p0lysim/FFB-base-differential/docs/images/drivetrain.jpg

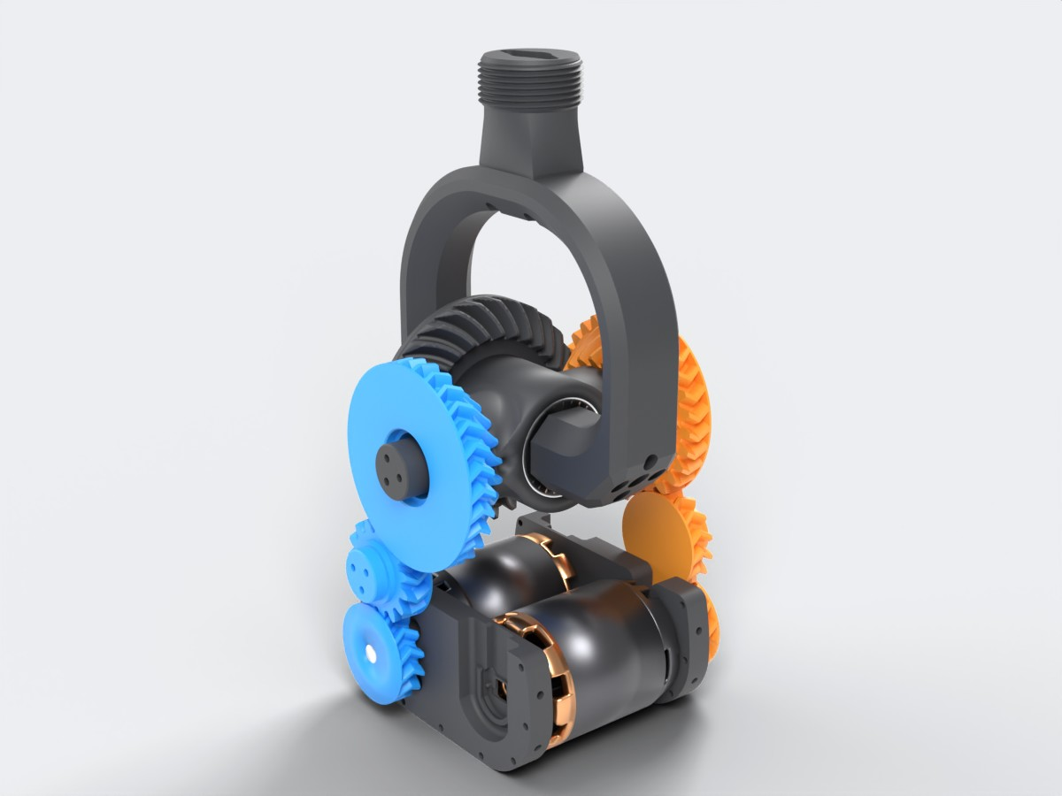
docs/images/drivetrain.jpg
