p0lysim/FFB-base-differential/docs/images/fusion360-model.png

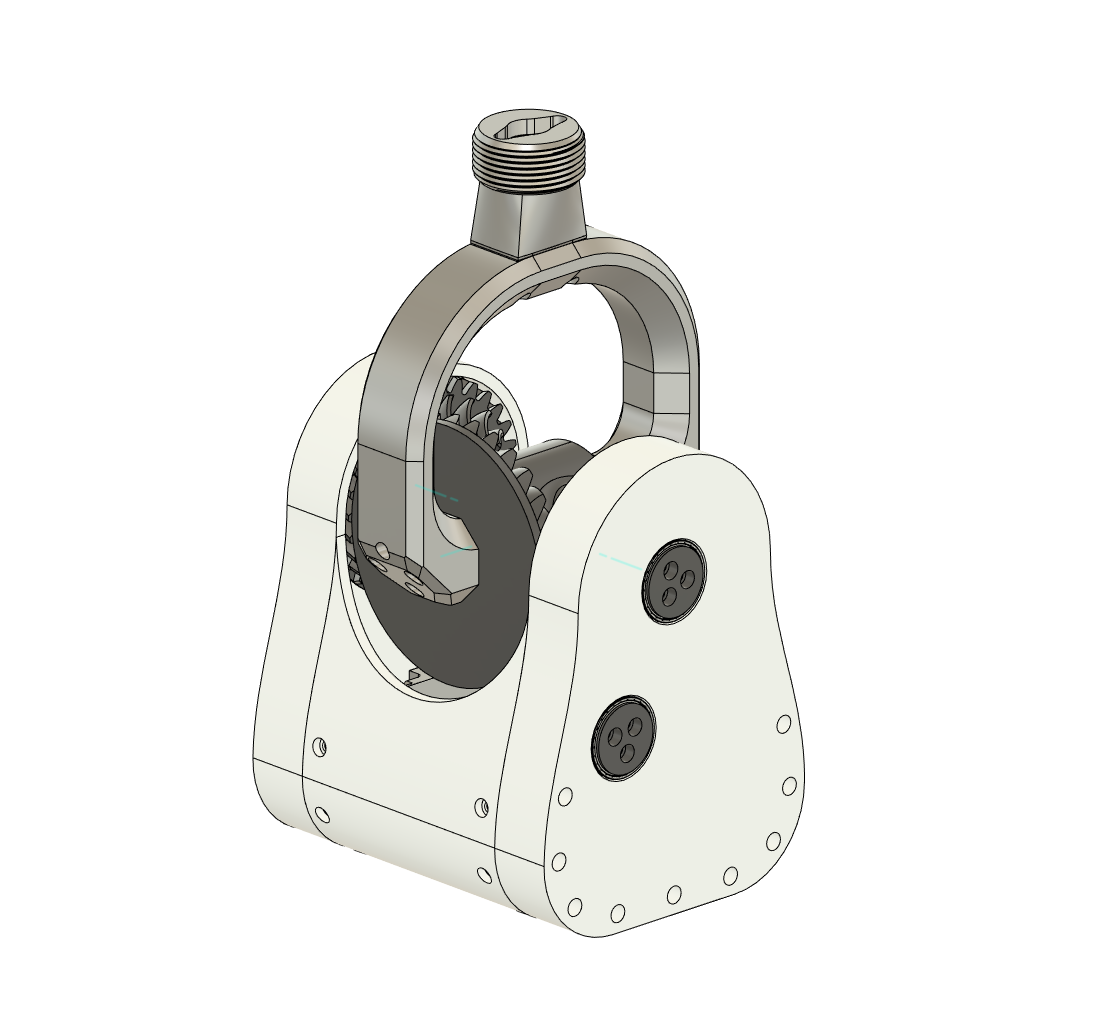
docs/images/fusion360-model.png
