p0lysim/FFB-base-differential/docs/images/render-back.jpg

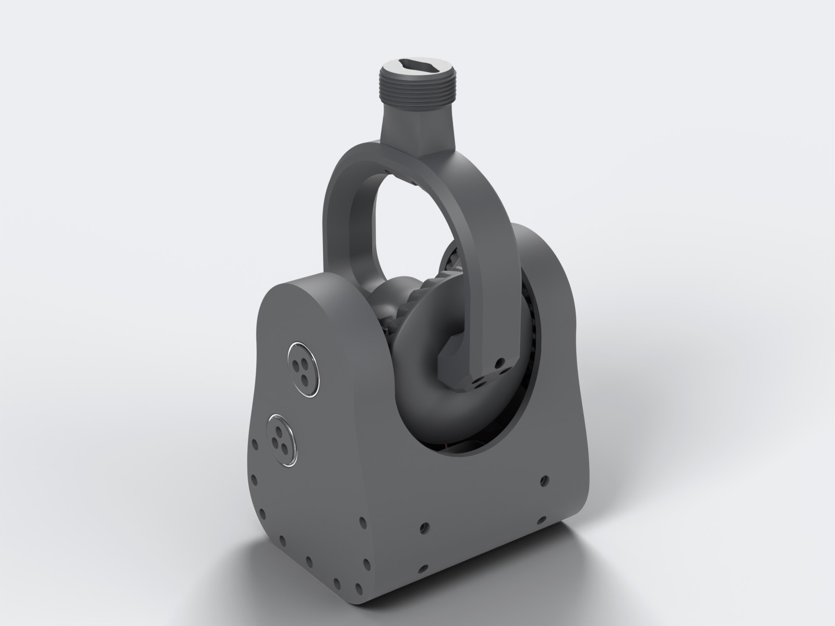
docs/images/render-back.jpg
