p0lysim/FFB-base-differential/docs/images/render-front.jpg

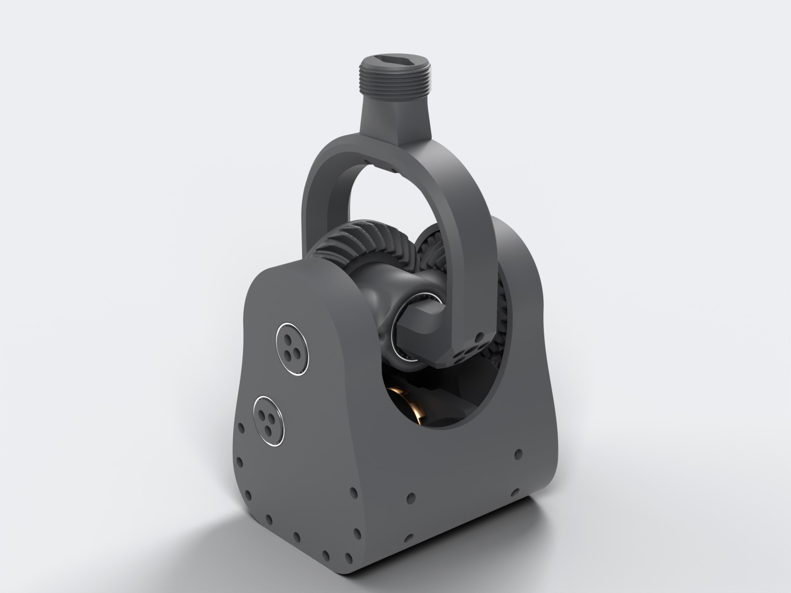
docs/images/render-front.jpg
