p0lysim/FFB-base-differential/docs/images/social-preview.jpg

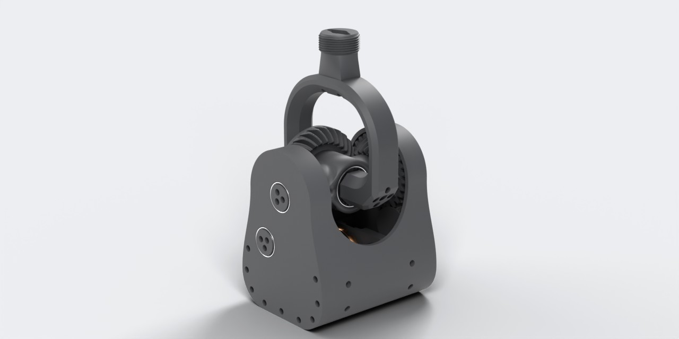
docs/images/social-preview.jpg
