p0lysim/FFB-base-differential/hardware/3mf/BambuStudio Project.3mf

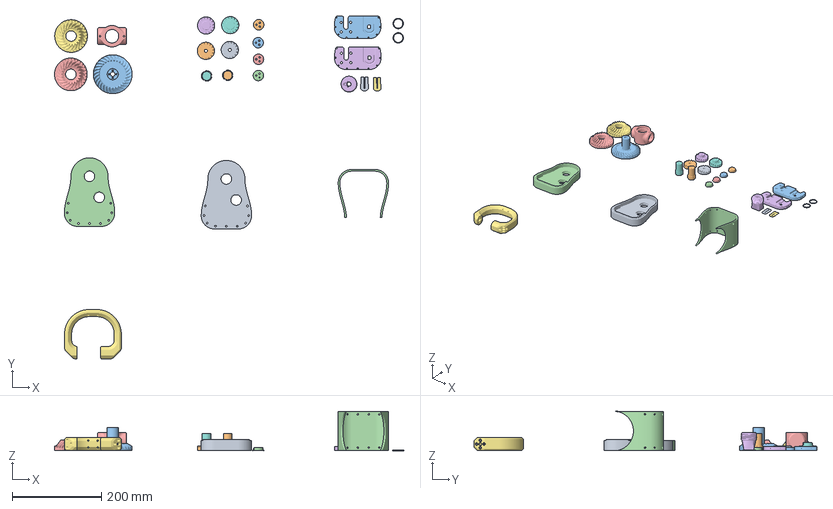
[picture p35: CAD file, 2026-11-09]
hardware/3mf/BambuStudio Project.3mf
781.8 x 768.0 x 88.4 mm
AS5048A_Cap_x2.stl x 2
Axis_Cap_x4.stl x 4
Big_Gear_x1.stl
Bottom_Panel_x1.stl
Gear_Hub_x1.stl
Grip_Holder_P1_x1.stl
Grip_Holder_P2_x1.stl
Hub_Axis_x2.stl x 2
Hub_Spacer_x2.stl x 2
Motor_Gear_x2.stl x 2
Motor_Support_x2.stl x 2
Side_Panel_x2.stl x 2
Small_Gear_x2.stl x 2
Transmission_Gear_x2.stl x 2
