p0lysim/FFB-base-differential/hardware/stl/Big_Gear_x1.stl

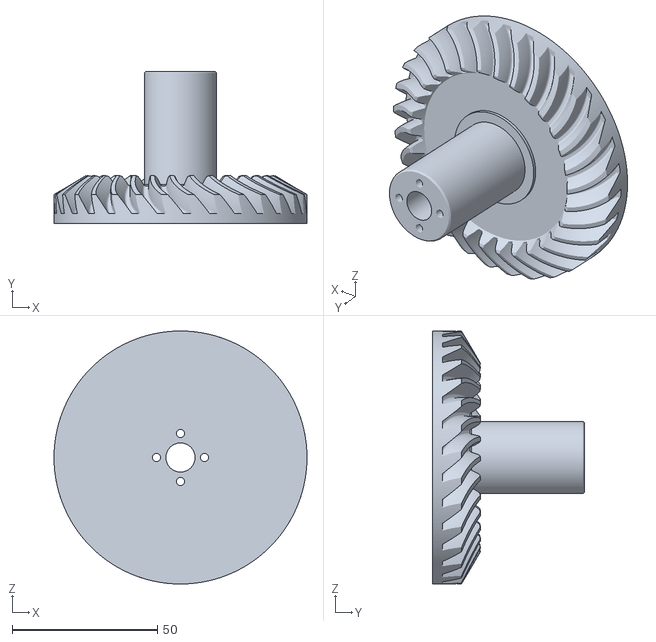
[picture p36: CAD file, 2026-11-09]
hardware/stl/Big_Gear_x1.stl
87.0 x 52.2 x 87.0
