p0lysim/FFB-base-differential/STL/Grip holder p2.stl

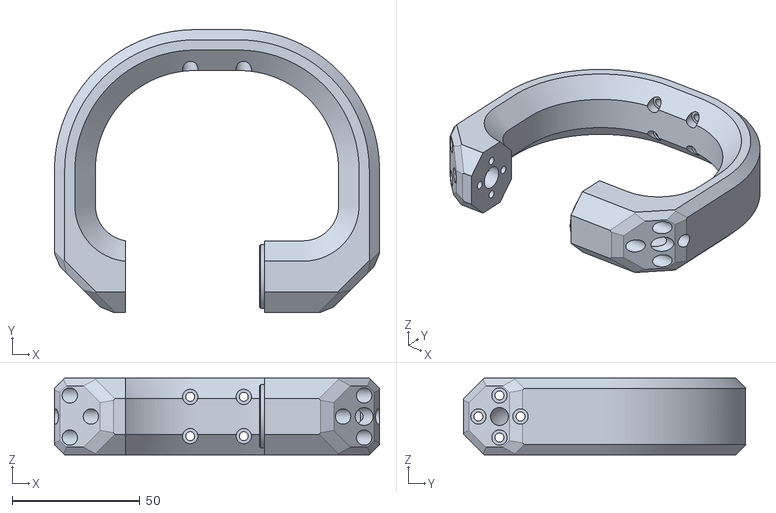
[picture p37: CAD file, 2025-08-08]
STL/Grip holder p2.stl
127.2 x 110.6 x 30.0
