p0lysim/FFB-base-differential/hardware/stl/Small_Gear_x2.stl

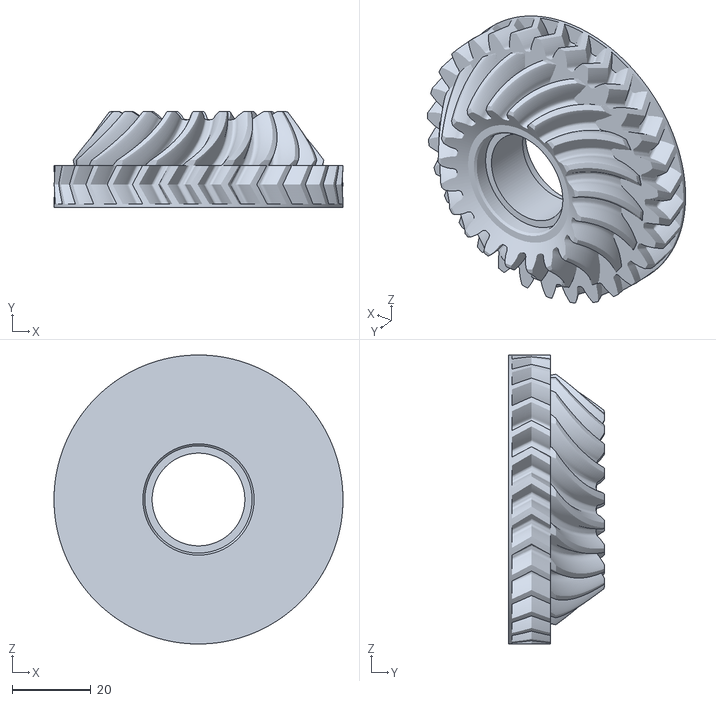
[picture p38: CAD file, 2026-11-09]
hardware/stl/Small_Gear_x2.stl
73.3 x 24.5 x 73.3
