p0lysim/FFB-base-differential/STL/Side panel X2.stl

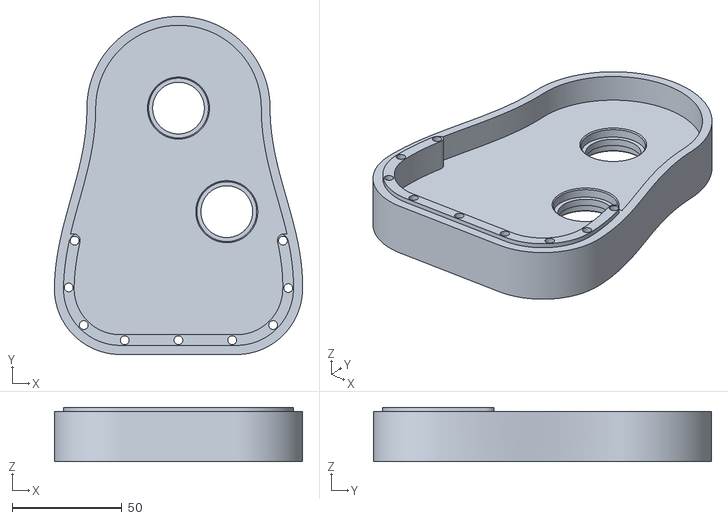
[picture p39: CAD file, 2025-08-08]
STL/Side panel X2.stl
112.9 x 153.7 x 24.6
