p0lysim/FFB-base-differential/hardware/stl/Hub_Axis_x2.stl

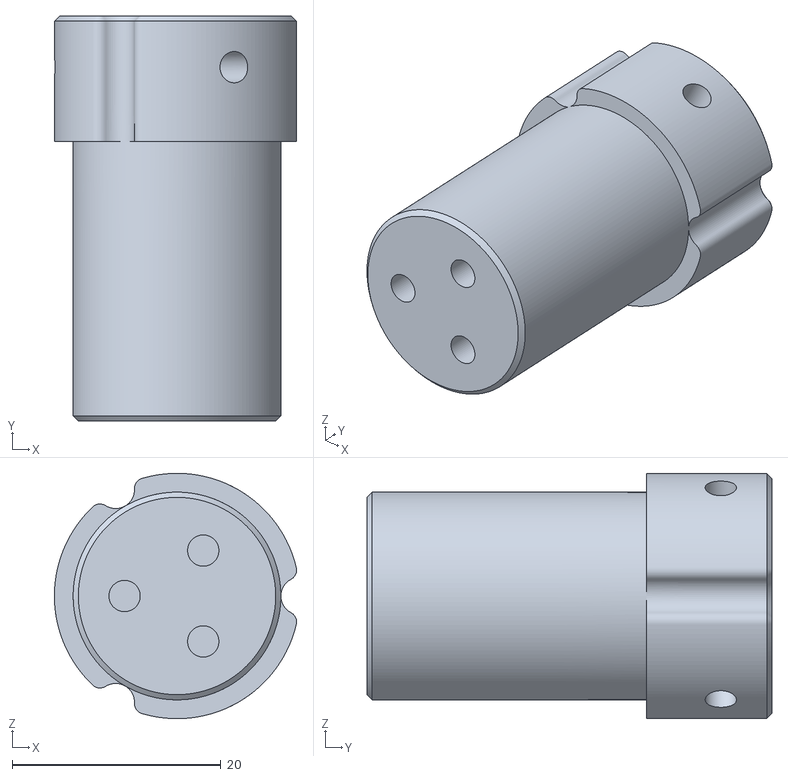
[picture p40: CAD file, 2025-08-08]
hardware/stl/Hub_Axis_x2.stl
23.2 x 38.8 x 23.5
