p0lysim/FFB-base-differential/STL/Bottom panel.stl

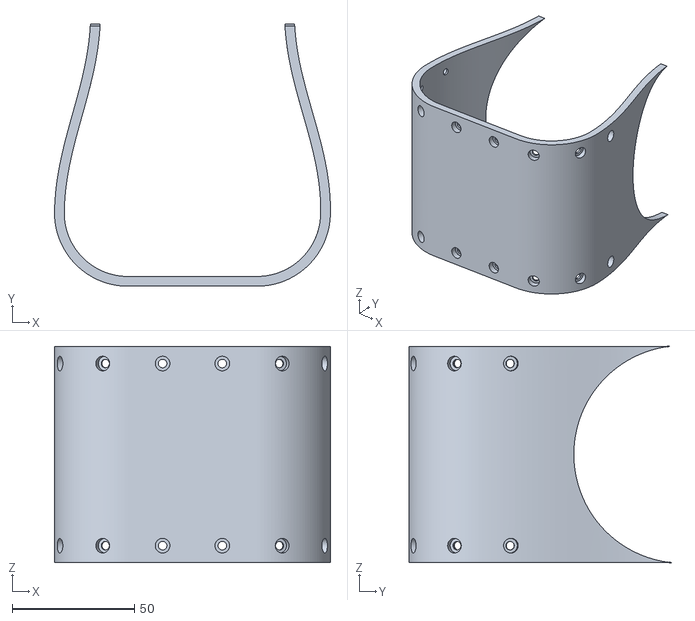
[picture p41: CAD file, 2025-08-08]
STL/Bottom panel.stl
112.9 x 107.3 x 88.4
