p0lysim/FFB-base-differential/hardware/stl/Grip_Holder_P1_x1.stl

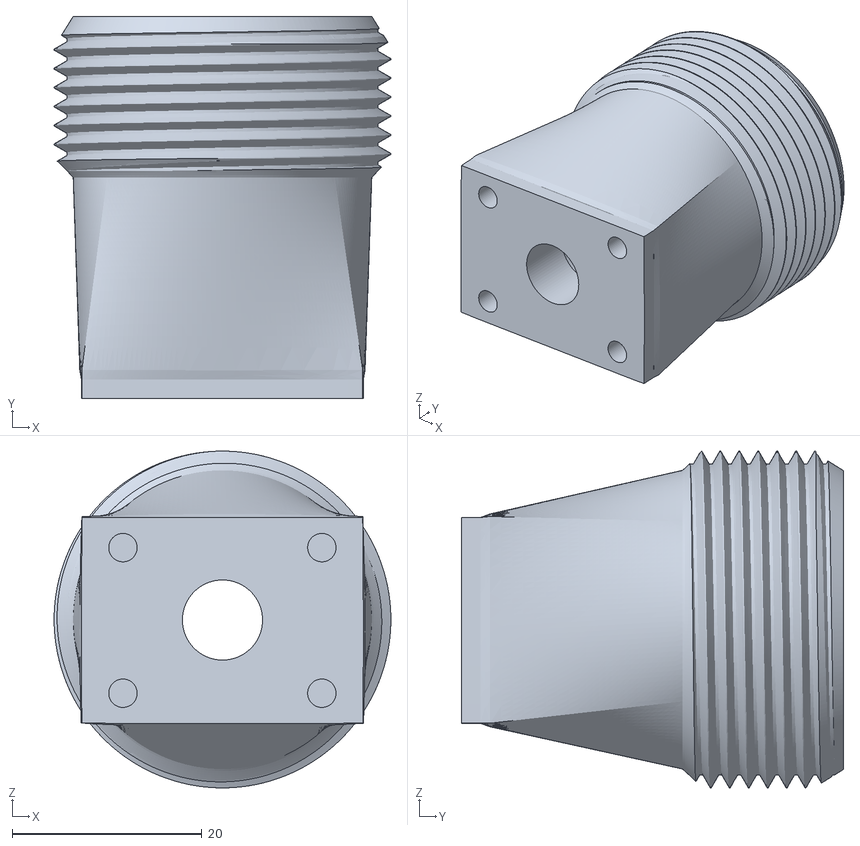
[picture p42: CAD file, 2025-08-08]
hardware/stl/Grip_Holder_P1_x1.stl
35.5 x 40.3 x 35.5
