p0lysim/FFB-base-differential/STL/Motor support X2.stl

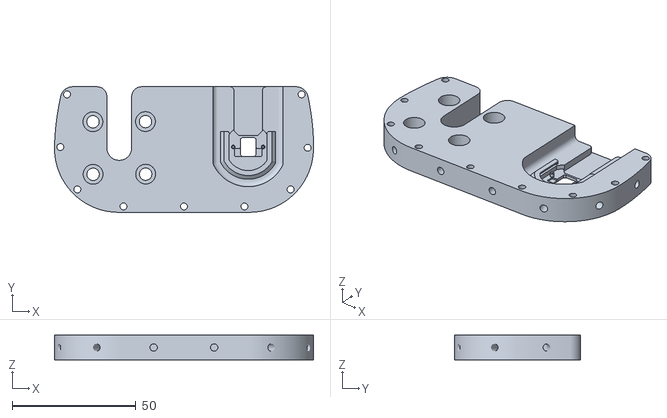
[picture p43: CAD file, 2025-08-08]
STL/Motor support X2.stl
104.6 x 50.7 x 10.0
