p0lysim/FFB-base-differential/hardware/stl/Transmission_Gear_x2.stl

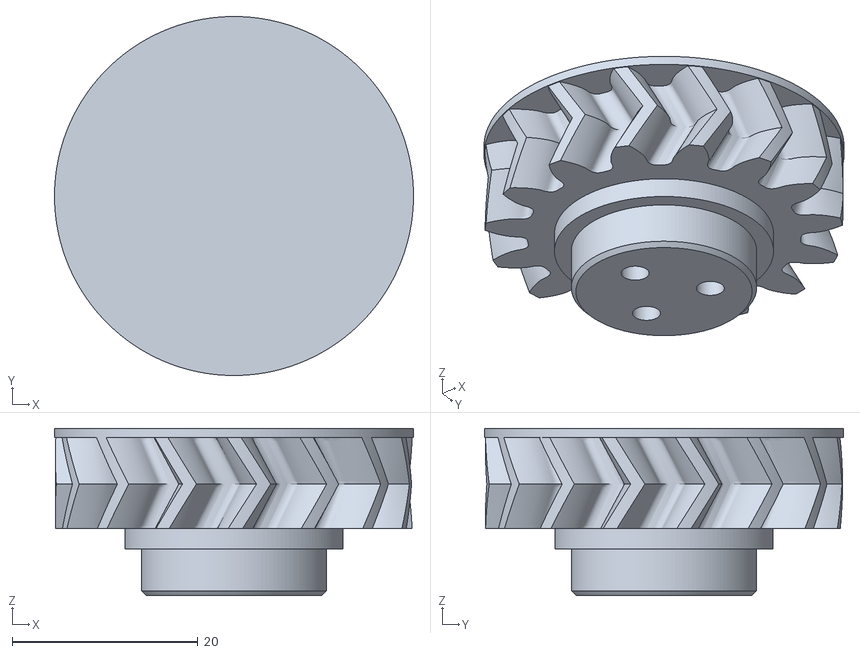
[picture p44: CAD file, 2025-08-08]
hardware/stl/Transmission_Gear_x2.stl
38.6 x 38.6 x 18.0
