p0lysim/FFB-base-differential/STL/Axis cap X4.stl

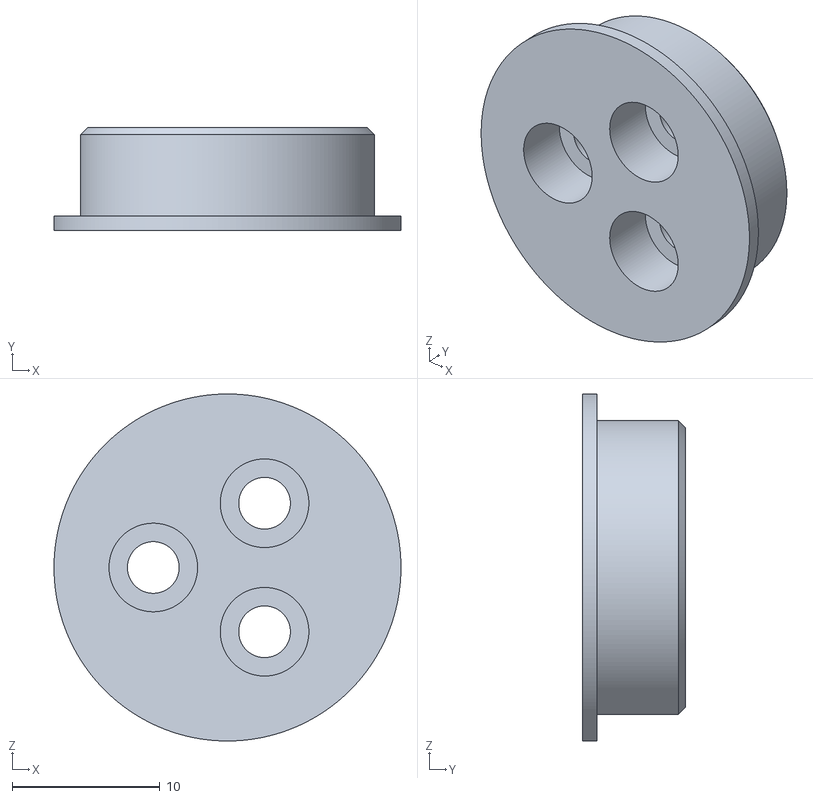
[picture p45: CAD file, 2025-08-08]
STL/Axis cap X4.stl
23.5 x 7.00 x 23.5
