p0lysim/FFB-base-differential/hardware/stl/Motor_Gear_x2.stl

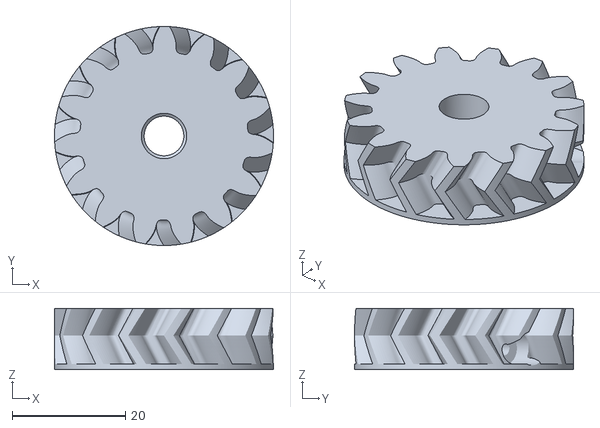
[picture p46: CAD file, 2025-08-08]
hardware/stl/Motor_Gear_x2.stl
38.6 x 38.6 x 10.8
