p0lysim/FFB-base-differential/STL/Gear hub.stl

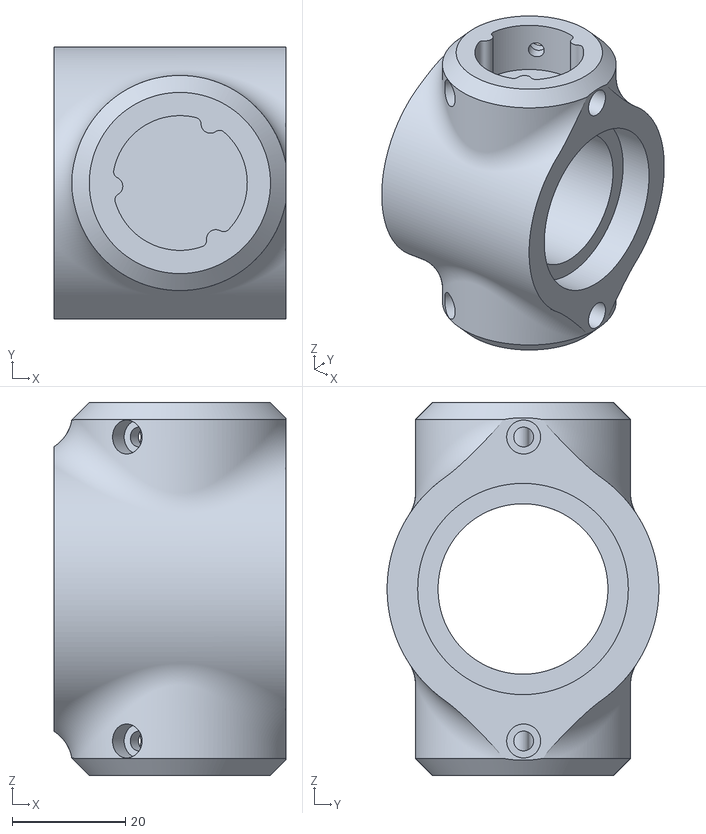
[picture p47: CAD file, 2025-08-08]
STL/Gear hub.stl
40.9 x 48.0 x 65.9
