p0lysim/FFB-base-differential/hardware/stl/AS5048A_Cap_x2.stl

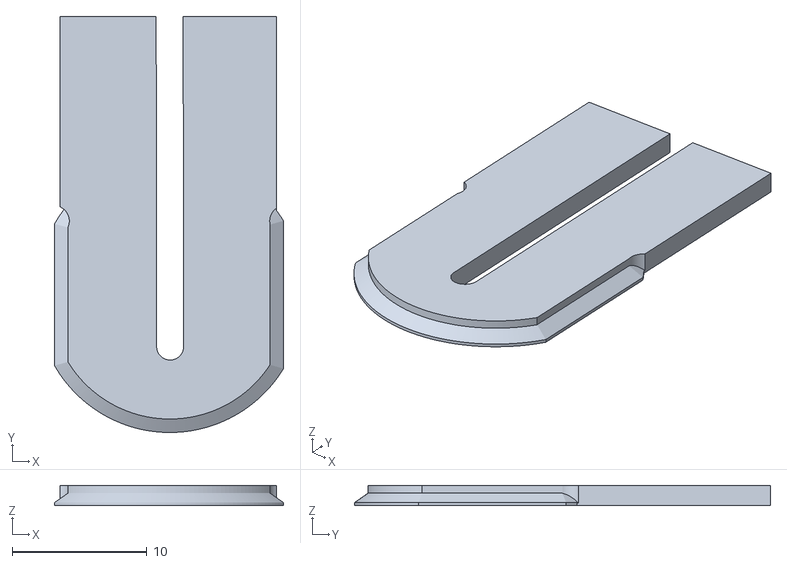
[picture p48: CAD file, 2025-08-08]
hardware/stl/AS5048A_Cap_x2.stl
17.0 x 30.9 x 1.50
