p0lysim/FFB-base-differential/hardware/stl/Hub_Spacer_x2.stl

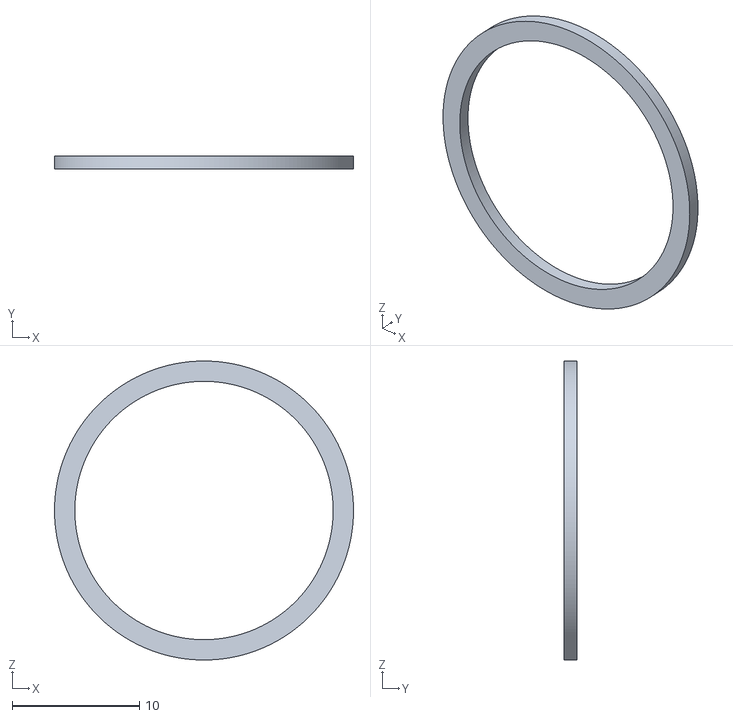
[picture p49: CAD file, 2025-08-08]
hardware/stl/Hub_Spacer_x2.stl
23.5 x 1.00 x 23.5
