p0lysim/FFB-base-differential/(list of files, cad)

Other CAD files:
hardware/step/FFB_Base_Differential_V2.step
