p0lysim/FFB-base-differential/(commit log)

2025-08-08 Add stl files
    [AS5058A cap.stl, Axis cap X4.stl, Bottom panel.stl, Gear hub.stl, Grip holder P1.stl, Grip holder p2.stl, Hub axis X2.stl, Hub spacer X2.stl]
2026-01-21 Add odrive configuration
    [GTR_SPI_CONFIG.txt]
2026-01-21 add step files fix #1
    [FFB_base.step]
2026-11-09 Refresh GitHub page: new README, assembly guide, renders and repo layout
    - New English README with demo GIF, highlights, honest project status,
    how-it-works animation, specifications, bill of materials with part
    thumbnails and an 8-step illustrated assembly guide
    - French README (README.fr.md)
    - Links to MakerWorld, Printables and Thingiverse pages
    - docs/how-it-works.md (gear ratios, kinematics, torque mixing) and
    docs/electronics-and-odrive.md (wiring, config walkthrough, tips)
    - Reorganized files: hardware/stl (quantity in file names, AS5048A typo
    fixed), hardware/step, firmware/odrive
    - Licenses: CC BY-NC-SA 4.0 for hardware, MIT for firmware/config
    - .gitignore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
2026-11-09 Simplify README: English only, shorter specs, fix step 1 bearing render
    Remove the French README and the status, printing, repository structure, history and contributing sections. Step 1 now shows one bearing inserted from each side of each bore.
